lnls-dig/fmc-5POF/(list of files, cad)

Other CAD files:
MECH/Panel FMC POF v1.ipt
