lnls-dig/fmc-5POF/(list of files, drawings)

Other design files:
circuit_board/Data_IO.SchDoc
circuit_board/fmc-5pof.PcbDoc
circuit_board/FMC_Conn.SchDoc
circuit_board/FMC_POF.PrjPcb
circuit_board/FMC_POF.SchDoc
circuit_board/POF.SchDoc
