lnls-dig/fmc-5POF/documentation/FMC-5CH-POF - hardware manual.odt

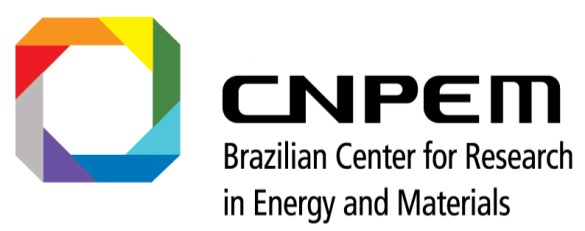
[picture p1: figure]
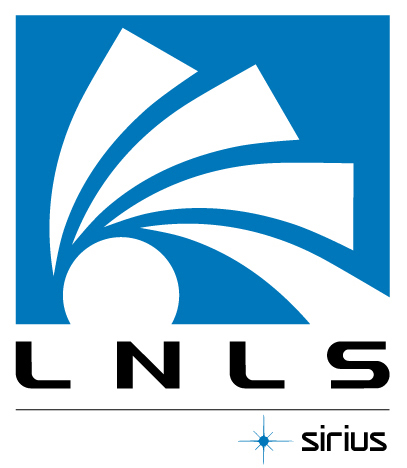
[picture p2: figure]

FMC-5CH-POF

hardware manual

Beam Diagnostics Group (DIG)

CERN Open Hardware Licence v1.2 Through this CERN Open Hardware Licence ("CERN OHL") version 1.2, CERN wishes to provide a tool to foster collaboration and sharing among hardware designers. The CERN OHL is copyright CERN. Anyone is welcome to use the CERN OHL, in unmodified form only, for the distribution of their own Open Hardware designs. Any other right is reserved. Release of hardware designs under the CERN OHL does not constitute an endorsement of the licensor or its designs nor does it imply any involvement by CERN in the development of such designs.

Beam Diagnostics Group

Brazilian Synchrotron Light Laboratory

Tel.: +55 19 3512-5071

Email: dig@lnls.br

# Introduction

The FMC-5CH-POF is a Vita 57 FMC LPC board, with 5 Versatile Link plastic optical fiber connectors, which can be either transmitters or receivers, depending on mounting options. The communication with the carrier board is done via LVDS signals, on either direction, and the direction of each channel is sent to the carrier through a single-ended signal.

# FMC connector signals

The board is low-pin-count (LPC) FMC card, following the Vita 57 Standard. Only the 3.3V power is used in the board, with the 3.3 VAux being used for the EEPROM. The 12V power rail is not used in this board, and left floating, while Vadj is only used to adjust signal levels. Vadj can, then, be set to any value within the FMC standard with no risk or loss of functionality.

The signal I/Os are LVDS, terminated with 100 Ohms inside the FMC card. To ensure appropriate signals when sending data to the FMC connector, the LVDS transceiver supports M-LVDS. The carrier may, then, act as an usual LVDS receiver, terminated with 100 Ohms.

Besides the data channels, the FMC-5CH-POF also has 5 direction signals in the FMC connector. These signals are natively 3.3V, but the traces have diodes connect to Vadj that ensure the output signals will never be higher than Vadj+0.6V. They are also equipped with 100 Ohms resistor in series, to avoid shorts and overcurrent.

Channel | Data signal (differential) | IsReceiver signal
1 | LA00_CC | LA07_P
2 | LA04 | LA05_P
3 | LA01_CC | LA05_N
4 | LA02 | LA06_P
5 | LA03 | LA06_N

Table 1 - Data signal pinout in the FMC connector

The mandatory Vita 57 FMC signals for EEPROM, and PRSNT_M2C_L, and VREF_A_M2C are all available. VREF_A_M2C is directly connected to the Vadj rail.

# FMC board identification

The EEPROM of this board contains the data as presented in the following tables, as defined by VITA57.1 and Platform Management FRU Information Storage Definition V1.1 standards. There are no custom records.

Area | Field | Value/Observation
Common Header | Format Version | 0x01 for this standard version
| Internal Use area offset | In 8 bytes count
| Chassis Info area offset | In 8 bytes count
| Board Info area offset | In 8 bytes count
| Product Info area offset | In 8 bytes count
| Multirecord area offset | In 8 bytes count
Internal Use | - | Not used
Chassis Info | - | Not used
Board Info | Language Code | 0x00 (English)
| Board manufacturing time | Number of minutes from 0:00 hrs 1/1/96
| Board manufacturer name
| Board name
| Board serial number
| Board part number
| FRU File ID | The FRU File version field is a pre-defined field provided as a manufacturing aid for verifying the file that was used during manufacture or field update to load the FRU information. The content is manufacturer-specific. This field is also provided in the Product Info area. Either or both fields may be ‘null’.
Product Info | Language Code | 0x00 (English)
| Product manufacturer name
| Product name
| Product part number
| Product version
| Asset tag
| Product serial number
| FRU File ID | (see Fru File ID in Board Info area)
Multirecord Area
FMC Subtype | Subtype/Version | 0x00 for this standard
| Module size | 0: Single width 1: Double width
| P1 Connector size | 0b00: LPC 0b01: HPC 0b11: Not fitted
| P2 Connector size | 0b00: LPC 0b01: HPC 0b11: Not fitted
| Clock direction (CLK2/3_BIDIR) | 0: M2C 1: C2M
| P1 Bank A signals count
| P1 Bank B signals count
| P2 Bank A signals count
| P2 Bank B signals count
| P1 GBT Transceivers count
| P2 GBT Transceivers count
| Max Clock for TCK | (not used, always 0)
FMC DC Load (one for each input power line – Vadj, +12V, +3V3) | Nominal Voltage | (in 10mV counts)
| Specificated minimum voltage | (in 10mV counts)
| Specificated maximum voltage | (in 10mV counts)
| Specificated ripple and noise pk-pk 10Hz to 30MHz | (in mV)
| Minimum current load | (in mA)
| Maximum current load | (in mA)
FMC DC Output | - | Not present

# POF connectors

The board is equipped with 5 Versatile Link connectors, which can either transmitters or receivers. The direction of the communication is defined by the board assembly and cannot be changed afterwards. Any combination of transmitters and receivers is allowed.

By the Versatile Link convention, transmitters are grey in color, while receivers are black. There are no other markers for the user for the direction of each connectors.

# Power supply

The board draws current only from the FMC connector's 3.3V and 3.3Vaux rails. The maximum estimated current for the 3.3V rail is 300mA. This board does not draws any current from Vadj and 12V rails in the FMC connector.

# Data communications

The transceivers are adequate for data communication, either asynchronous or synchronous (using separate transmitters or receivers for data and clock signal). The specified data rate for the transmitters and receivers is 50Mbd.

Testing with a loopback formed by the FMC-5CH-POF two 9 meters-long POF in SP605 at ~70Mbd, using a synchronous communication protocol, the bit error rate is less than 1*10⁻¹² with a 99% confidence. This is more than enough for most communication applications.
