lnls-dig/fmc-5POF/(commit log)

2017-02-13 Initial commit, only schematics
    [Data_IO.SchDoc, FMC_Conn.SchDoc, FMC_POF.PrjPcb, FMC_POF.SchDoc, POF.SchDoc]
2017-02-15 Initial placement of the files
    [Data_IO.SchDoc, FMC_Conn.SchDoc, FMC_POF.PrjPcb, fmc-5pof.PcbDoc]
2017-02-15 Changed footprint of C23 to match other caps
    [FMC_Conn.SchDoc, fmc-5pof.PcbDoc]
2017-02-15 Five channels routed
    [fmc-5pof.PcbDoc]
2017-02-15 routed VCC_POF
    [fmc-5pof.PcbDoc]
2017-02-15 Routed IC3
    [fmc-5pof.PcbDoc]
2017-02-15 Changed LPC pins to better adhere to VITA57.1
    [FMC_Conn.SchDoc]
2017-02-16 Some rules changes
    [FMC_Conn.SchDoc, FMC_POF.PrjPcb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]
2017-02-20 Changed POF numbers to follow better order
    Changed the NETS and Rooms numbers so that they stay in incremental order in teh PCB
    [Data_IO.SchDoc, FMC_Conn.SchDoc, FMC_POF.PrjPcb]
2017-02-20 Increased POF trace width
    [FMC_Conn.SchDoc]
2017-02-20 Corrected POF connectors' positions
    [FMC_Conn.SchDoc]
2017-02-20 Added bypass cap for buffer IC2
    [Data_IO.SchDoc]
2017-02-20 Added channel numbers to silk screen
    [Data_IO.SchDoc, FMC_POF.PrjPcb]
2017-02-21 Added testpoints for manufactuing
    [Data_IO.SchDoc, FMC_Conn.SchDoc]
2017-02-21 Adjusted silkscreen
2017-03-03 Removed coupling capacitors in LVDS lines
    This will allow for triggers to be sending using the POF. Fixes #5
    [Data_IO.SchDoc, POF.SchDoc]
2017-03-09 Updated schematics structure
    Added comments to clarify design details
    Added fiducial targets
    Added variants for all possible transmitter numbers
    Removed uncessary top level page
    [Data_IO.SchDoc, FMC_Conn.SchDoc, FMC_POF.PrjPcb, FMC_POF.SchDoc, POF.SchDoc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]
2017-03-09 Small documentation changes to prepare for manufacturing
    [Data_IO.SchDoc, FMC_Conn.SchDoc, FMC_POF.PrjPcb]
2017-06-19 Add panel mech
    [Panel FMC POF v1.ipt]
2017-06-27 Changed led position for a better viewing while mounted
2017-06-28 Change order on panel CH1 to CH5
    [Panel FMC POF v1.ipt]
2017-07-04 Changed FMC connector for 8.5mm one
    This will allow better mounting in boards with front panel, as the POF
    transmitter/receivers pins violate the FMC limits with the
    standard-height board.
    [Data_IO.SchDoc, FMC_Conn.SchDoc]
2017-07-05 Updated J1 parameters in the PCB
2017-07-05 Updated PrjPcb with single-side assembly variant
    [FMC_POF.PrjPcb]
